glidernet/diy-tracker/README.md

# diy-tracker
Do-it-Yourself OGN Tracker software
