glidernet/diy-tracker/(threads)

Thread 6 (2017-12-27):

$POGNS is unable to set negative values for Tx power or frequency correction

lyusupov, 2017-12-27:
Suggested fix:

```
    $ diff  format.h.orig format.h
    69c69
    <      Len+=Read_UnsDec(Int, Inp); if(Sign=='-') Int=(-Int);
    ---
    >      Len+=Read_UnsDec(Int, Inp+Len); if(Sign=='-') Int=(-Int);
    $
```

It works good for me.

Closed 2019-02-07.

Thread 12 (2018-02-27):

GPGGA/GPRMC from an external source

kicune, 2018-02-27:
Not an issue, rather a polite question: do you have any plans (or better yet, any progress?) to receive NMEA GPS coordinates from an external source, say, on RX3/TX3 UART?

There is a note mentioning "read NMEA user input" in main.cpp, but I am not quite sure what it should comprise.

And if there is indeed some plan to implement this, how high a priority that one is (meaning: should I wait patiently, or would you recommend me to start hacking instead)?

Anyway, this one is a fantastic project - thank you a lot for your effort & keep it up!

pjalocha, 2018-02-27:
What external source do you have there ?
You can feed this source into UART2, simply instead of the GPS.
The only thing is the timing. Ideally you provide the PPS, if not the tracker get get less precise timing from the UART2 data arrival. Why don't you try with the source you have already ?

kicune, 2018-02-28:
Oh, you are right! I don't know why I got the idea that the GPS module is connected via SPI, silly me. :|

The NMEA data would come from existing logger installation. The logger publishes a bunch of other stuff in addition to GPGGA/GPRMC, but as I checked the source, this should not pose a problem.
There is no PPS available, though, sadly.

In addition, there is also PGRMZ altitude information available in the logger NMEA stream, but it's probably not worth digging it out - these BP180/280 works quite nicely and they have no special needs regarding orientation and signal reception as GPS does.

I'll check it out, many thanks for your suggestion!

pjalocha, 2018-02-28:
I can read the PGRMZ, no problem.
I just hear that the PGRMZ has double definition: it can send pressure altitude or pressure altitude corrected for QNH.

The important thing is the timing: we need to know the delay from the start of the second to the start of the GPS data, and hopefully this timing is stable. This can be worked out.
I think you can try already: just connect the GPS data source to the OGN tracker and see what comes out on the console, it should as well start transmitting.

kicune, 2018-02-28:
Well, I have to say it worked rather nicely! I connected the TTL outputs to UART2 and was able to see GPGGA/GPRMC sentences right away. It wasn't even necessary to recompile the tracker without gps_pps support. I yet have to test it with GPS lock and RF transmit, but at the moment I am still waiting for my RF modules to arrive. It will be also necessary to test it with direct logger output, as my setup utilized the "NMEA output" device in XCSoar. But, it's a promising start.

Why it is necessary to know the pps delay anyways? It has to do something with synchronization between various connected devices?

Yes, PGRMZ can be a pain in the ass, if I understand it correctly - for Garmin it's baro altitude, for others (eg. FLARM) it's pressure altitude. Make your pick. Just another reason to use a dedicated sensor, fwiw...

One other question, if I may: How does the PFLAA support works? It seems to me that it is hidden behind WITH_PFLAA ifdef; this is however not published as an option in the makefile. Will the "standardized" FLARM-like output work, if I enable it manually?

Closed 2018-02-28.

Thread 15 (2018-06-25):

GPS module with no PPS port

kusree, 2018-06-25:
Can I use GPS module with no PPS port? like NEO6MV2 or BN-8xx module?

pjalocha, 2018-06-25:
In principle yes, the code can extract the timing from the data sent by the
GPS, this works better with STM32 than on the ESP32
but as the timing is not very critical the device should still perform well.

Pawel.

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

kusree, 2018-07-01:
ok, thank you

Closed 2018-07-01.

Thread 16 (2018-07-08):

disabling the GPS PPS

kusree, 2018-07-08:
I still cannot figure how to use non-PPS GPS module?

i tried to change "GPS_Status.PPS=0;" in gps.cpp but not working

pjalocha, 2018-07-08:
First, it should work without you doing anything.
The algorithm gets the timing from the data bursts getting from the GPS.
What happens when you simply run the code without modifications ?

Pawel.

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

kusree, 2018-07-09:
I just realized that the OGN receiver automatically change the RF frequency center to the Australia region (915Mhz) based on my location. that's why the receiver can not listen to the device. First, I though  it was the gps problem. Now I have to find out how to change the center frequency back to 868.3MHz

pjalocha, 2018-07-09:
Both OGN receiver and the OGN-Tracker should change the frequency plan
according to the geographical location.
In the OGN receiver you can override it by RF.FreqPlan=1; (for
Europe/Africa)
but in the OGN-Tracker there is no override.

Where are you and which frequency plan do you need ?

Pawel.

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

kusree, 2018-07-09:
I'm in Indonesia, and planning to use 868MHz instead of Australia region freq

pjalocha, 2018-07-09:
OK, to force a given frequency plan in the OGN Tracker please do the following:
 in proc.cpp remove the like:

      RF_FreqPlan.setPlan(Position->Latitude, Position->Longitude);     // set the frequency plan according to the GPS position

In rf.cpp change the line:

  RF_FreqPlan.setPlan(0);                  // 1 = Europe/Africa, 2 = USA/CA, 3 = Australia and South America

to:

RF_FreqPlan.setPlan(1);

kusree, 2018-07-09:
Yes, in Indonesia we are using 868mhz.

thank you pjalocha, will try it to set the fixed freqplan

pjalocha, 2018-07-24:
i have added the parameter FreqPlan to the STM32 and ESP32 OGN-Tracker so that you can override the automatic setting based on the location. For 868MHz send this to the console:

$POGNS,FreqPlan=1

the parameters are stored in the flash thus the Tracker remembers them after a reset or re-power.

kusree, 2018-07-24:
thank you pjalocha. I will try it

Thread 18 (2020-07-16):

Esp32 Led for arduino Flash

teacdance, 2020-07-16:
Where i found code to upload if i use arduino

pjalocha, 2020-07-16:
There is no code for Arduino, what board you have ?

teacdance, 2020-07-16:
Heltec ESP32 with oled

Thread 19 (2023-06-07):

Installation Manual?

ryanrrinport, 2023-06-07:
Hi just wondering if there's any instructions for this? I'm using a TTGO T-beam and I'm in Canada so it's the 915 band.

pjalocha, 2023-06-07:
Please check the project for the ESP32 CPU: https://github.com/pjalocha/esp32-ogn-tracker
use the T-Beam_v10.cfg file of another depending on your exact hardware.
If you have issues, please contact me.

ryanrrinport, 2023-06-07:
awesome thank you!

Closed 2023-06-08.
