glidernet/diy-tracker/PCB/DIY-Tracker.kicad_pcb

## KiCad design PCB/DIY-Tracker.kicad_pcb (2015-09-08)

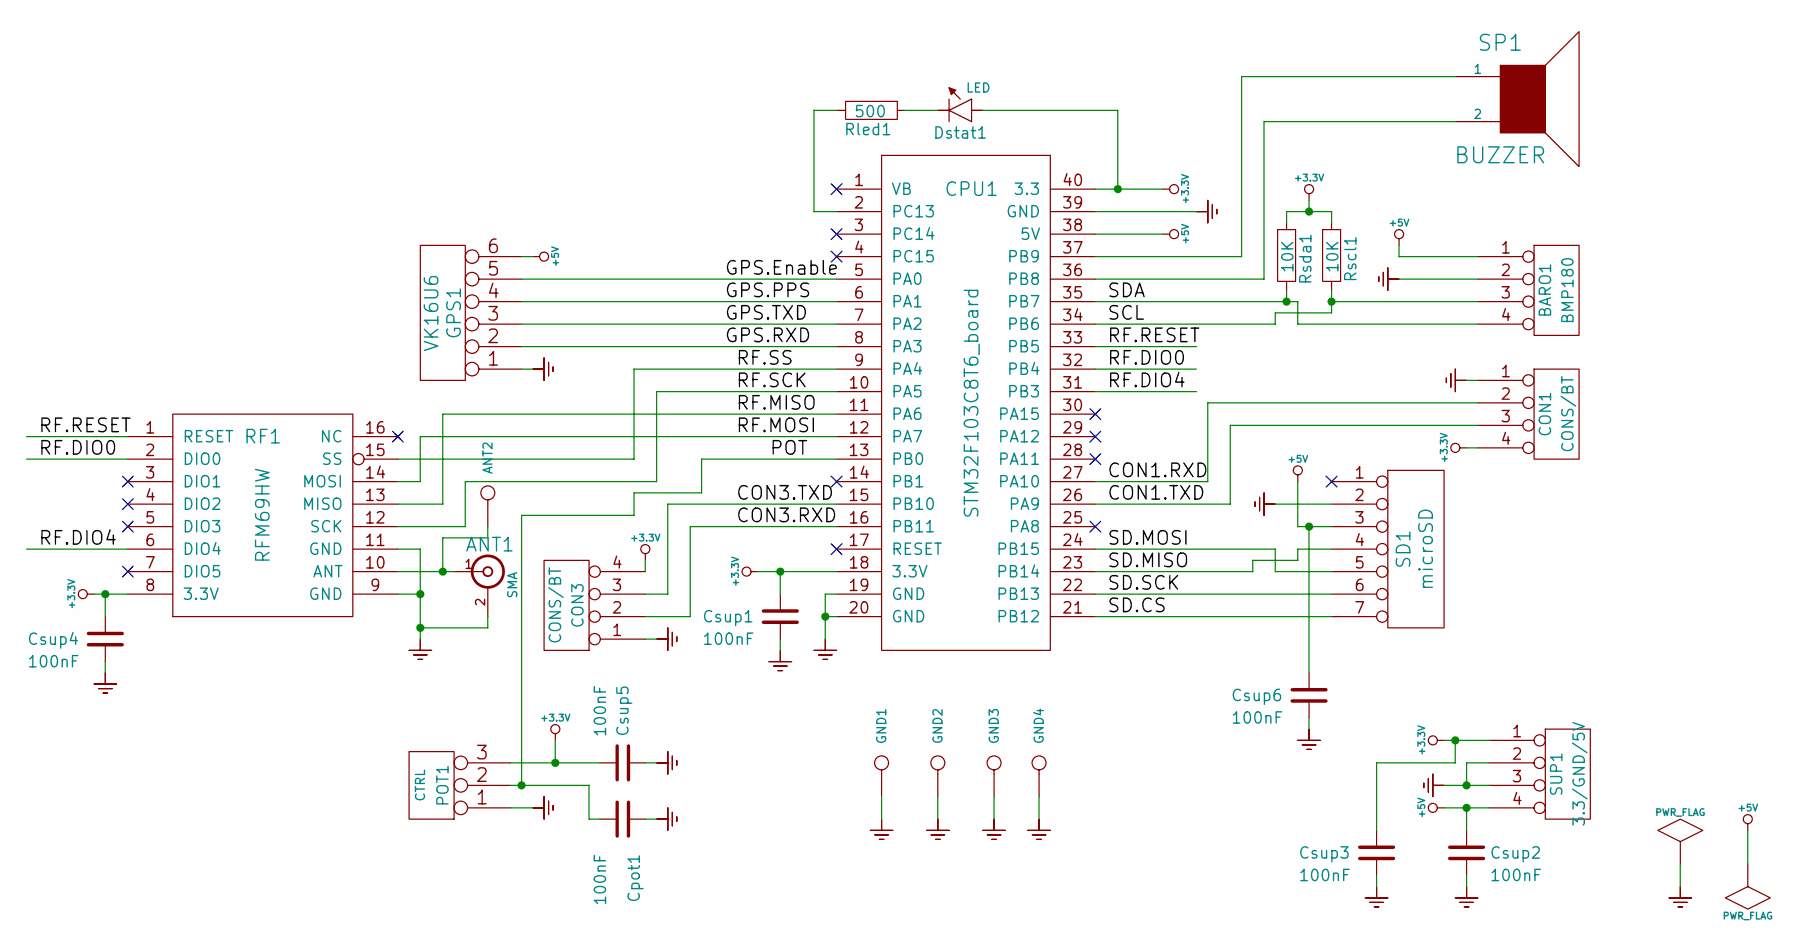
[picture p1: schematic DIY-Tracker.sch, DIY-Tracker board]

Parts:
ANT1: SMA; SIL-2
ANT2: CONN_1; 1pin
BARO1: BMP180; SIL-4
CON1, CON3: CONS/BT; SIL-4
CPU1: STM32F103C8T6_board; DIP-40__600_ELL
Cpot1: 100nF; c_1206
Csup1, Csup2, Csup3, Csup4, Csup5, Csup6: 100nF; c_1206
Dstat1: LED; SIL-2
GND1, GND2, GND3, GND4: CONN_1; 1pin
GPS1: VK16U6; SIL-6
POT1: CTRL; SIL-3
RF1: RFM69HW
Rled1: 500; c_1206
Rscl1: 10K; c_1206
Rsda1: 10K; c_1206
SD1: microSD; SIL-7
SP1: BUZZER; SIL-2
SUP1: 3.3/GND/5V; SIL-4

Connections:
+3.3V: CON1.4, CON3.4, CPU1.18 (3.3V), CPU1.40 (3.3), Csup1.1, Csup3.1, Csup4.1, Csup5.2, Dstat1.1 (A), POT1.3, RF1.8 (3.3V), Rscl1.1, Rsda1.1, SUP1.1
+5V: BARO1.1, CPU1.38 (5V), Csup2.1, Csup6.1, GPS1.6, SD1.3, SUP1.4
/CON1.RXD: CON1.2, CPU1.27 (PA10)
/CON1.TXD: CON1.3, CPU1.26 (PA9)
/CON3.RXD: CON3.2, CPU1.16 (PB11)
/CON3.TXD: CON3.3, CPU1.15 (PB10)
/GPS.Enable: CPU1.5 (PA0), GPS1.5
/GPS.PPS: CPU1.6 (PA1), GPS1.4
/GPS.RXD: CPU1.8 (PA3), GPS1.2
/GPS.TXD: CPU1.7 (PA2), GPS1.3
/POT: CPU1.13 (PB0), Cpot1.2, POT1.2 (PM)
/RF.DIO0: CPU1.32 (PB4), RF1.2 (DIO0)
/RF.DIO4: CPU1.31 (PB3), RF1.6 (DIO4)
/RF.MISO: CPU1.11 (PA6), RF1.13 (MISO)
/RF.MOSI: CPU1.12 (PA7), RF1.14 (MOSI)
/RF.RESET: CPU1.33 (PB5), RF1.1 (RESET)
/RF.SCK: CPU1.10 (PA5), RF1.12 (SCK)
/RF.SS: CPU1.9 (PA4), RF1.15 (SS)
/SCL: BARO1.3, CPU1.34 (PB6), Rscl1.2
/SD.CS: CPU1.21 (PB12), SD1.7
/SD.MISO: CPU1.23 (PB14), SD1.4
/SD.MOSI: CPU1.24 (PB15), SD1.5
/SD.SCK: CPU1.22 (PB13), SD1.6
/SDA: BARO1.4, CPU1.35 (PB7), Rsda1.2
GND: ANT1.2 (Ext), BARO1.2, CON1.1, CON3.1, CPU1.19 (GND), CPU1.20 (GND), CPU1.39 (GND), Cpot1.1, Csup1.2, Csup2.2, Csup3.2, Csup4.2, Csup5.1, Csup6.2, GND1.1, GND2.1, GND3.1, GND4.1, GPS1.1, POT1.1, RF1.9 (GND), RF1.11 (GND), SD1.2, SUP1.2, SUP1.3
unnamed: ANT1.1 (In), ANT2.1, RF1.10 (ANT)
unnamed: CPU1.2 (PC13), Rled1.2
unnamed: CPU1.36 (PB8), SP1.2
unnamed: CPU1.37 (PB9), SP1.1
unnamed: Dstat1.2 (K), Rled1.1

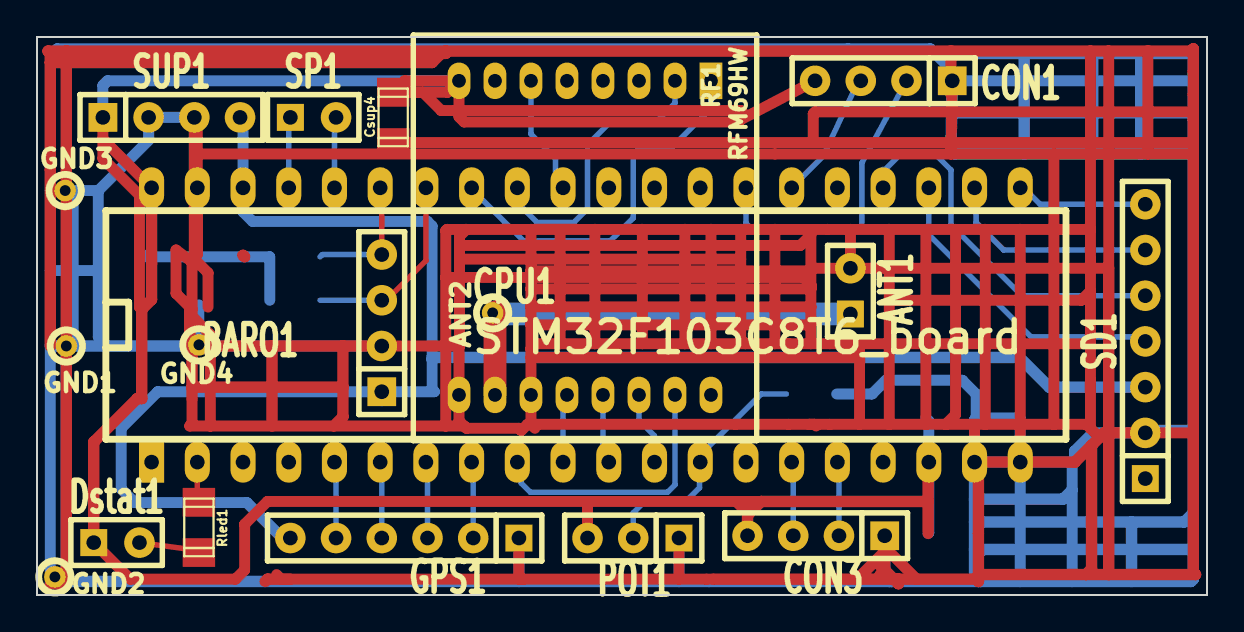
[picture p2: board DIY-Tracker.kicad_pcb from above]

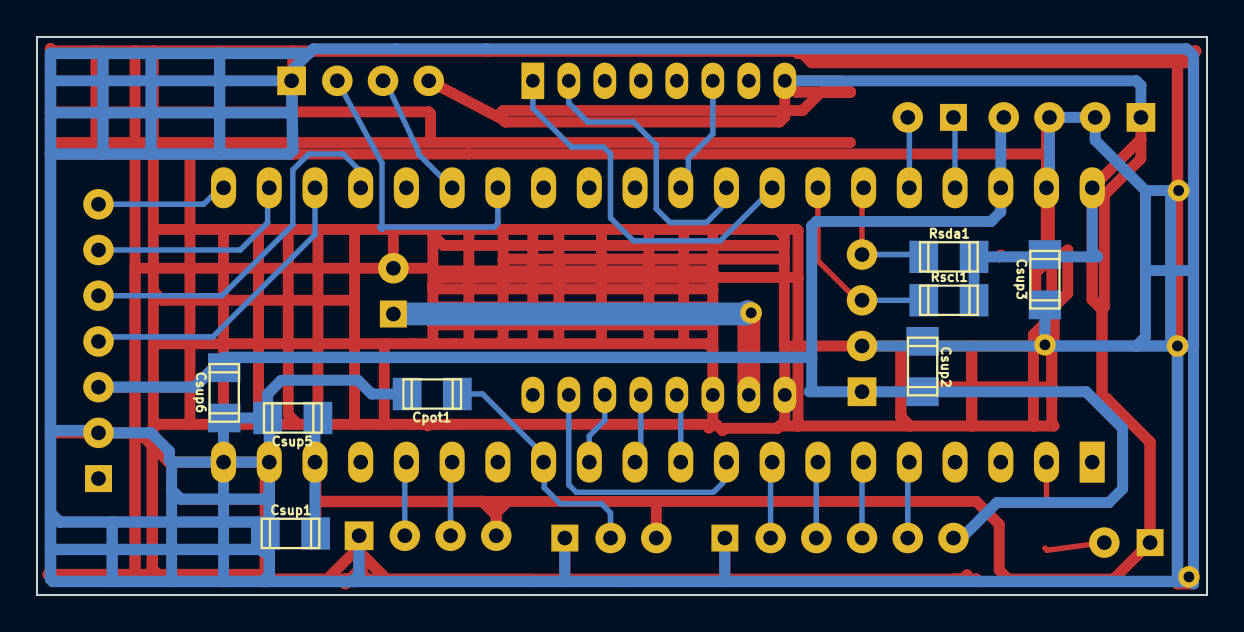
[picture p3: board DIY-Tracker.kicad_pcb from below]

Board: 2 copper layers, 65.0 x 31.0 mm, 27 parts (8 on the bottom side), 30 nets.
