glidernet/diy-tracker/(commit log)

2015-04-13 Default Tx power (and RF chip type)
2015-07-26 lot of small fixes
    [beep.cpp, main.cpp, ogn.h, sd.cpp, spi2.cpp]
2015-08-07 Packet relay, transmit baro data
2015-08-08 small bug in PrioQueue and some comments
    [ogn.h]
2015-08-08 packet-relay, tx timing
2015-08-12 BMP180 recovery, SDlog fully buffered by a FIFO, few bugs fixed
    [ctrl.cpp, ctrl.h, i2c.cpp, i2c.h, main.cpp, ogn.h, spi2.cpp]
2015-08-12 system would dead-lock on writing to log-file buffer: fixed
    [ctrl.cpp]
2015-08-13 Bug fixed around copying time from one GPS record to the next
    [ogn.h]
2015-08-15 Tracker would transmit zero-coordinate when GPS lock was lost - fixed
    [ogn.h]
2015-09-08 Add PCB files: KiCAD project
    [DIY-Tracker-B_Cu.gbr, DIY-Tracker-B_Mask.gbr, DIY-Tracker-B_SilkS.gbr, DIY-Tracker-Edge_Cuts.gbr, DIY-Tracker-F_Cu.gbr, DIY-Tracker-F_Mask.gbr, DIY-Tracker-F_SilkS.gbr, DIY-Tracker-drl_map.gbr]
2016-08-22 Bug fix in Unix time calculation
    [ogn.h]
2017-03-16 Major rewrite, several bugs fixed, frequency plan for other continents
    [ctrl.cpp, lowpass_test.cc, main.cpp, ogn.h, rfm69.h, systick.h, uart.cpp]
2017-04-21 Limit bandwidth of some I/O pins to reduce noise
    [beep.cpp, i2c.cpp, spi1.cpp, uart.cpp]
2017-04-21 Fixed conflict between knob and OGN-CURE-1 RF
    [adc.cpp]
2017-04-25 Bug fixed in pressure altitude encoding
    [ogn.h]
2017-04-25 Autobaud on GPS UART, not tested
2017-05-02 Pass-through for GPS control frames from/to the console
2017-05-16 Fixed bug in the freq. hopping
    [freqplan_test.cc]
2017-09-30 Support old MMC and SDC1 cards
    These cards do not support CMD8 command and return response 0x05
    instead. According to http://elm-chan.org/docs/mmc/mmc_e.html:
    > If the CMD8 is rejected with illigal command error (0x05), the card is
    > SDC version 1 or MMC version 3.
    This adds support for such cards.
    [sd.cpp]
2017-10-07 Old bug in pressure altitude calculation was back - fixed again
    [atmosphere.h, atmosphere_test.cc]
2018-01-13 Wait longer for valid GPS signal before switching baud rate
    Otherwise GPS tunes out from a good baud rate from time to time.
2018-02-25 FlashLog, Push I2C to HAL, essential files are identical now to the ESP32 version for easy passing of new features
2018-03-05 Fix compilation issue with MAPLE_MINI
    [hal.cpp]
2018-03-08 Update bme280.h
    fixed an over loading mistake in Acquire() .
    [bme280.h]
2018-03-09 Add some info-parameters, move I2C mutex into hal.cpp
2018-11-08 new encoding for temperature and humidity to increase accuracy around the normal values
